dvogureckiy99/stove-master/docs_eng/README.md

 # stove
 
[По-русски](../README.md) | **In english** 
 
## DEVELOPMENT OF THE LAYOUT OF THE SOFTWARE AND HARDWARE COMPLEX FOR TEMPERATURE CONTROL IN FURNACES FOR GLASS MASKS BASED ON THE ATMEGA2560 MICROCONTROLLER
 
 Code use for control temp write in Arduino IDE for board Arduino MEGA.
