dvogureckiy99/stove-master/examples/README.md

# Примеры, которые использовались во время выполнения проекта.
[назад](../README.md)

В [данной папке]() находится проект.

1. Расчёт времени регулирования и запись в файл в [calculating_sattling_time.ino](calculating_sattling_time.ino)

2. Код, который используется для быстрого  написания функций на дисплее [code_for_display.txt](code_for_display.txt)

3. Испытательный код для отработки парсинга строки со значениями точек нагрева с Nextion [Nextion_parsing.cpp](Nextion_parsing.cpp)

4. Проверка на равенство двух массивов [equal_array.cpp](equal_array.cpp)

5. переводит целое число number в строку char* и дополняет слева незначащими нулями
	до длины size. Если количество цифр в числе больше желаемого размера массива, то
	возвращается указатель на нуль символ.
	При успешном выполнении возвращается указатель на требуемую строку. [fix_size.cpp](fix_size.cpp)
