dvogureckiy99/stove-master/docs/images/README.md

# Картинки к проекту 

1. Блок-схема алгоритма Основной алогритм.
