dvogureckiy99/stove-master/docs/stove_bookmarks.md

[назад](../README.md)

<!DOCTYPE NETSCAPE-Bookmark-file-1>
<!-- This is an automatically generated file.
     It will be read and overwritten.
     DO NOT EDIT! -->
<META HTTP-EQUIV="Content-Type" CONTENT="text/html; charset=UTF-8">
<H1>Bookmarks Menu</H1>

<DL><p>
            <DT><H3 ADD_DATE="1589473120" LAST_MODIFIED="1589473121">Stove</H3>
            <DL><p>
                <DT><H3 ADD_DATE="1589473120" LAST_MODIFIED="1589473121">комплектующие</H3>
                <DL><p>
                    <DT><H3 ADD_DATE="1589473120" LAST_MODIFIED="1589473120">PIC18</H3>
                    <DL><p>
                        <DT><A HREF="https://chipmk.ru/2014-08-10-05-51-44/41-samouchitel-pic18-asm-2-chast/190-porty-vvoda-vyvoda-mk-pic18xxxx" ADD_DATE="1551014720" LAST_MODIFIED="1551014720" ICON_URI="fake-favicon-uri:https://chipmk.ru/2014-08-10-05-51-44/41-samouchitel-pic18-asm-2-chast/190-porty-vvoda-vyvoda-mk-pic18xxxx" ICON="">Порты ввода/вывода МК PIC18XXXX.</A>
                        <DT><A HREF="http://picguides.com/beginner/config.php" ADD_DATE="1551014927" LAST_MODIFIED="1551014927">pic guides</A>
                        <DT><A HREF="https://www.youtube.com/watch?v=rUYyZlbiKuc&list=PLIMnyb3KvN1hQQfVPeeVTynqG2ni-zoCh&index=3" ADD_DATE="1558464573" LAST_MODIFIED="1558464573" ICON_URI="fake-favicon-uri:https://www.youtube.com/watch?v=rUYyZlbiKuc&list=PLIMnyb3KvN1hQQfVPeeVTynqG2ni-zoCh&index=3" ICON="">3. Знакомство с программой MPLAB X. (Урок 3. Теория) - YouTube</A>
                    </DL><p>
                    <DT><H3 ADD_DATE="1589473120" LAST_MODIFIED="1589473120">arduino mini</H3>
                    <DL><p>
                        <DT><A HREF="http://doc.arduino.ua/ru/hardware/ProMini" ADD_DATE="1531340918" LAST_MODIFIED="1531340918" ICON_URI="fake-favicon-uri:http://doc.arduino.ua/ru/hardware/ProMini" ICON="">ProMini Платы Ардуино</A>
                        <DT><A HREF="https://all-arduino.ru/arduino-pro-mini/" ADD_DATE="1531249484" LAST_MODIFIED="1531249484" ICON_URI="fake-favicon-uri:https://all-arduino.ru/arduino-pro-mini/" ICON="">Arduino Pro Mini Описание, распиновка, ШИМ, КУПИТЬ.</A>
                        <DT><A HREF="http://arduino.ru/Guide/ArduinoMini" ADD_DATE="1531248896" LAST_MODIFIED="1531248896" ICON_URI="fake-favicon-uri:http://arduino.ru/Guide/ArduinoMini" ICON="">Подключение Arduino Mini | Аппаратная платформа Arduino</A>
                        <DT><A HREF="http://mkprog.ru/avr/avr-dlya-nachinayushhih-urok-3-porty-vvoda-vyvoda.html" ADD_DATE="1532029238" LAST_MODIFIED="1532029238" ICON_URI="fake-favicon-uri:http://mkprog.ru/avr/avr-dlya-nachinayushhih-urok-3-porty-vvoda-vyvoda.html" ICON="">регистры pinx,</A>
                        <DT><A HREF="http://atmega8.ru/wiki/view/doc.24.html" ADD_DATE="1532430288" LAST_MODIFIED="1532430288" ICON_URI="fake-favicon-uri:http://atmega8.ru/wiki/view/doc.24.html" ICON="">ATMega8 / Широтно-импульсная модуляция (ШИМ)</A>
                        <DT><A HREF="https://micro-pi.ru/arduino-pro-mini-%D0%BE%D0%B1%D0%B7%D0%BE%D1%80-%D0%BF%D0%BE%D0%B4%D0%BA%D0%BB%D1%8E%D1%87%D0%B5%D0%BD%D0%B8%D0%B5/" ADD_DATE="1544714093" LAST_MODIFIED="1544714093" ICON_URI="fake-favicon-uri:https://micro-pi.ru/arduino-pro-mini-%D0%BE%D0%B1%D0%B7%D0%BE%D1%80-%D0%BF%D0%BE%D0%B4%D0%BA%D0%BB%D1%8E%D1%87%D0%B5%D0%BD%D0%B8%D0%B5/" ICON="">Arduino Pro Mini - Описание, распиновка платы - MicroPi</A>
                    </DL><p>
                    <DT><H3 ADD_DATE="1589473120" LAST_MODIFIED="1589473120">arduino nano</H3>
                    <DL><p>
                        <DT><A HREF="http://arduino.ru/Hardware/ArduinoBoardnano" ADD_DATE="1534321525" LAST_MODIFIED="1534321525" ICON_URI="fake-favicon-uri:http://arduino.ru/Hardware/ArduinoBoardnano" ICON="">Arduino Nano | Аппаратная платформа Arduino</A>
                        <DT><A HREF="http://arduino.proger.site/faq/icsp" ADD_DATE="1534322704" LAST_MODIFIED="1534322704" ICON_URI="fake-favicon-uri:http://arduino.proger.site/faq/icsp" ICON="">Для чего нужен разъем ISCP на плате ардуино UNO? - FAQ - ARDUINO РОБОТ</A>
                    </DL><p>
                    <DT><H3 ADD_DATE="1589473120" LAST_MODIFIED="1589473120">aduino mega</H3>
                    <DL><p>
                        <DT><A HREF="https://store.arduino.cc/arduino-mega-2560-rev3" ADD_DATE="1535822159" LAST_MODIFIED="1535822159" ICON_URI="fake-favicon-uri:https://store.arduino.cc/arduino-mega-2560-rev3" ICON="">Arduino Mega 2560 Rev3</A>
                        <DT><A HREF="http://wiki.amperka.ru/%D0%BF%D1%80%D0%BE%D0%B4%D1%83%D0%BA%D1%82%D1%8B:arduino-mega-2560" ADD_DATE="1543830371" LAST_MODIFIED="1543830371" ICON_URI="fake-favicon-uri:http://wiki.amperka.ru/%D0%BF%D1%80%D0%BE%D0%B4%D1%83%D0%BA%D1%82%D1%8B:arduino-mega-2560" ICON="">Arduino Mega 2560 [Амперка / Вики]</A>
                        <DT><A HREF="https://voltiq.ru/wp-content/uploads/arduino-mega-2560-pinouts-1019x720.jpg" ADD_DATE="1548351164" LAST_MODIFIED="1548351164" ICON_URI="fake-favicon-uri:https://voltiq.ru/wp-content/uploads/arduino-mega-2560-pinouts-1019x720.jpg" ICON="">arduino-mega-распиновка (1019×720)</A>
                    </DL><p>
                    <DT><A HREF="https://arduinomaster.ru/platy-arduino/maketnaya-plata-arduino/" ADD_DATE="1531589305" LAST_MODIFIED="1531589305" ICON_URI="fake-favicon-uri:https://arduinomaster.ru/platy-arduino/maketnaya-plata-arduino/" ICON="">Беспаечная макетная плата breadboard в проектах Ардуино</A>
                    <DT><A HREF="http://wiki.amperka.ru/%D1%81%D1%85%D0%B5%D0%BC%D0%BE%D1%82%D0%B5%D1%85%D0%BD%D0%B8%D0%BA%D0%B0:%D1%80%D0%B5%D0%B7%D0%B8%D1%81%D1%82%D0%BE%D1%80%D1%8B" ADD_DATE="1531739923" LAST_MODIFIED="1531739923" ICON_URI="fake-favicon-uri:http://wiki.amperka.ru/%D1%81%D1%85%D0%B5%D0%BC%D0%BE%D1%82%D0%B5%D1%85%D0%BD%D0%B8%D0%BA%D0%B0:%D1%80%D0%B5%D0%B7%D0%B8%D1%81%D1%82%D0%BE%D1%80%D1%8B" ICON="">Резисторы [Амперка / Вики]</A>
                    <DT><H3 ADD_DATE="1589473120" LAST_MODIFIED="1589473120">термопары</H3>
                    <DL><p>
                        <DT><H3 ADD_DATE="1589473120" LAST_MODIFIED="1589473120">термоконтроллео через spi</H3>
                        <DL><p>
                            <DT><A HREF="http://www.count-zero.ru/2015/max6675/" ADD_DATE="1532019486" LAST_MODIFIED="1532019486" ICON_URI="fake-favicon-uri:http://www.count-zero.ru/2015/max6675/" ICON="">Подключение термопары К-типа к Arduino используя модуль на MAX6675</A>
                            <DT><A HREF="http://www.count-zero.ru/2015/spi/" ADD_DATE="1532019520" LAST_MODIFIED="1532019520" ICON_URI="fake-favicon-uri:http://www.count-zero.ru/2015/spi/" ICON="">Программная реализация SPI интерфейса, на примере подключения термопары K-типа, через адаптер MAX6675 к микроконтроллеру ATmega8</A>
                        </DL><p>
                        <DT><A HREF="https://www.maximintegrated.com/en/products/sensors/MAX31856.html" ADD_DATE="1531761697" LAST_MODIFIED="1531761697" ICON_URI="fake-favicon-uri:https://www.maximintegrated.com/en/products/sensors/MAX31856.html" ICON="">Термопара точности MAX31856 к цифровому Преобразователю с Выпрямлением-Максим</A>
                        <DT><A HREF="http://www.goodluckbuy.com/cjmcu-max31856-thermocouple-module-high-precision-development-board.html" ADD_DATE="1531761273" LAST_MODIFIED="1531761273" ICON_URI="fake-favicon-uri:http://www.goodluckbuy.com/cjmcu-max31856-thermocouple-module-high-precision-development-board.html" ICON="">CJMCU-MAX31856 Thermocouple Module High Precision Development Board $18.97 Free Shipping @GoodLuckBuy.com</A>
                        <DT><A HREF="https://www.compel.ru/2015/12/22/max31856-atsp-dlya-termopar-s-zashhitoy-i-linearizatsiey" ADD_DATE="1531761363" LAST_MODIFIED="1531761363" ICON_URI="fake-favicon-uri:https://www.compel.ru/2015/12/22/max31856-atsp-dlya-termopar-s-zashhitoy-i-linearizatsiey" ICON="">MAX31856 – АЦП для термопар с защитой и линеаризацией</A>
                        <DT><A HREF="https://learn.adafruit.com/adafruit-max31856-thermocouple-amplifier/wiring-and-test" ADD_DATE="1532110282" LAST_MODIFIED="1532110282" ICON_URI="fake-favicon-uri:https://learn.adafruit.com/adafruit-max31856-thermocouple-amplifier/wiring-and-test" ICON="">Wiring &amp; Test | Adafruit MAX31856 Universal Thermocouple Amplifier | Adafruit Learning System</A>
                        <DT><A HREF="http://docs.cntd.ru/document/1200028583" ADD_DATE="1532168873" LAST_MODIFIED="1532168873" ICON_URI="fake-favicon-uri:http://docs.cntd.ru/document/1200028583" ICON="">ГОСТ Р 8.585-2001 Государственная система обеспечения единства измерений (ГСИ). Термопары. Номинальные статические характеристики преобразова</A>
                        <DT><A HREF="https://github.com/engineertype/MAX31856" ADD_DATE="1536413307" LAST_MODIFIED="1536413307" ICON_URI="fake-favicon-uri:https://github.com/engineertype/MAX31856" ICON="">MAX31856</A>
                        <DT><A HREF="http://arduino.ru/forum/programmirovanie/otkuda-arduino-ide-beret-inkludy" ADD_DATE="1536418636" LAST_MODIFIED="1536418636" ICON_URI="fake-favicon-uri:http://arduino.ru/forum/programmirovanie/otkuda-arduino-ide-beret-inkludy" ICON="">Откуда Arduino IDE берет инклуды? | Аппаратная платформа Arduino</A>
                    </DL><p>
                    <DT><H3 ADD_DATE="1589473121" LAST_MODIFIED="1589473121">тестеры</H3>
                    <DL><p>
                        <DT><A HREF="http://www.radiomexanik.spb.ru/7.-izmeritelnyie-priboryi/3.-vozdeystvie-voltmetra-na-izmeryaemuyu-tsep.html" ADD_DATE="1532171627" LAST_MODIFIED="1532171627" ICON_URI="fake-favicon-uri:http://www.radiomexanik.spb.ru/7.-izmeritelnyie-priboryi/3.-vozdeystvie-voltmetra-na-izmeryaemuyu-tsep.html" ICON="">3. Воздействие вольтметра на измеряемую цепь | 7. Измерительные приборы | Часть1 - DС</A>
                    </DL><p>
                    <DT><H3 ADD_DATE="1589473121" LAST_MODIFIED="1589473121">пид-регулятор</H3>
                    <DL><p>
                        <DT><A HREF="http://brettbeauregard.com/blog/2011/04/improving-the-beginners-pid-introduction/" ADD_DATE="1532173038" LAST_MODIFIED="1532173038">Improving the Beginner’s PID – Introduction « Project Blog</A>
                        <DT><A HREF="http://playground.arduino.cc/Code/PIDLibrary" ADD_DATE="1532177255" LAST_MODIFIED="1532177255" ICON_URI="fake-favicon-uri:http://playground.arduino.cc/Code/PIDLibrary" ICON="">Arduino Playground - PIDLibrary</A>
                        <DT><A HREF="https://github.com/br3ttb/Arduino-PID-Library" ADD_DATE="1532177259" LAST_MODIFIED="1532177259" ICON_URI="fake-favicon-uri:https://github.com/br3ttb/Arduino-PID-Library" ICON="">br3ttb/Arduino-PID-Library</A>
                        <DT><A HREF="http://mypractic.ru/urok-40-pid-regulyator-princip-dejstviya-matematicheskoe-opisanie-nastrojka.html" ADD_DATE="1532177265" LAST_MODIFIED="1532177265" ICON_URI="fake-favicon-uri:http://mypractic.ru/urok-40-pid-regulyator-princip-dejstviya-matematicheskoe-opisanie-nastrojka.html" ICON="">Уроки Ардуино. ПИД регулятор. Принцип действия, математическое описание, настройка. | Оборудование, технологии, разработки</A>
                        <DT><A HREF="http://bigbarrel.ru/arduino_pid/" ADD_DATE="1532177269" LAST_MODIFIED="1532177269" ICON_URI="fake-favicon-uri:http://bigbarrel.ru/arduino_pid/" ICON="">PID регулятор температуры. Климат контроль на Ардуино. Библиотека PID ← BigBarrel.ru</A>
                        <DT><A HREF="https://studopedia.ru/7_161119_nastroyka-parametrov-regulyatora-po-metodu-ziglera-i-nikolsa.html" ADD_DATE="1532370032" LAST_MODIFIED="1532370032" ICON_URI="fake-favicon-uri:https://studopedia.ru/7_161119_nastroyka-parametrov-regulyatora-po-metodu-ziglera-i-nikolsa.html" ICON="">Настройка параметров регулятора по методу Зиглера и Никольса — Студопедия</A>
                        <DT><A HREF="http://lazysmart.ru/osnovy-avtomatiki/nastrojka-pid-regulyatora/" ADD_DATE="1536432524" LAST_MODIFIED="1536432524" ICON_URI="fake-favicon-uri:http://lazysmart.ru/osnovy-avtomatiki/nastrojka-pid-regulyatora/" ICON="">Практические советы по настройке ПИД-регулятора | LAZY SMART</A>
                    </DL><p>
                    <DT><H3 ADD_DATE="1589473121" LAST_MODIFIED="1589473121">аналоговая схемотехника</H3>
                    <DL><p>
                        <DT><H3 ADD_DATE="1589473121" LAST_MODIFIED="1589473121">семистр</H3>
                        <DL><p>
                        </DL><p>
                    </DL><p>
                    <DT><H3 ADD_DATE="1589473121" LAST_MODIFIED="1589473121">дисплей</H3>
                    <DL><p>
                        <DT><A HREF="https://ru.made-in-china.com/co_nextion/product_Nextion-Enhanced-Nx8048k050-Generic-5-0-HMI-Touch-Display_rurhihiyg.html" ADD_DATE="1533236357" LAST_MODIFIED="1533236357" ICON_URI="fake-favicon-uri:https://ru.made-in-china.com/co_nextion/product_Nextion-Enhanced-Nx8048k050-Generic-5-0-HMI-Touch-Display_rurhihiyg.html" ICON="">Усовершенствованная Nextion Nx8048K050 - 5,0&quot; сенсорный экран ИЧМ – Усовершенствованная Nextion Nx8048K050 - 5,0&quot; сенсорный экран ИЧМ предоставлен Itead Intelligent Syst</A>
                        <DT><A HREF="https://ru.aliexpress.com/item/Nextion-5-0-NX8048K050-800x480-UART/32892259749.html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" ADD_DATE="1533236488" LAST_MODIFIED="1533236488" ICON_URI="fake-favicon-uri:https://ru.aliexpress.com/item/Nextion-5-0-NX8048K050-800x480-UART/32892259749.html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" ICON="">Nextion расширение 5,0 &quot;NX8048K050 800x480 резистивный Сенсорный экран ичм UART Smart Дисплей модуль для Arduino Raspberry Pi ESP8266 купить на AliExpress</A>
                        <DT><A HREF="https://www.itead.cc/ru/nextion-nx8048t050.html" ADD_DATE="1533236565" LAST_MODIFIED="1533236565" ICON_URI="fake-favicon-uri:https://www.itead.cc/ru/nextion-nx8048t050.html" ICON="">Nextion NX8048T050 5&quot; HMI TFT LCD Интеллектуальный сенсорный дисплей</A>
                        <DT><A HREF="https://nextion.itead.cc/resources/datasheets/nx8048k050_011/" ADD_DATE="1533236689" LAST_MODIFIED="1533236689" ICON_URI="fake-favicon-uri:https://nextion.itead.cc/resources/datasheets/nx8048k050_011/" ICON="">NX8048K050_011 - Nextion</A>
                        <DT><A HREF="https://www.ti.com/lit/an/slyt209a/slyt209a.pdf" ADD_DATE="1533237334" LAST_MODIFIED="1533237334" ICON_URI="fake-favicon-uri:https://www.ti.com/lit/an/slyt209a/slyt209a.pdf" ICON="">Using resistive touch screens for human/machine interface</A>
                        <DT><A HREF="http://easyelectronics.ru/rabota-s-rezistivnym-sensornym-ekranom.html" ADD_DATE="1533240290" LAST_MODIFIED="1533240290" ICON_URI="fake-favicon-uri:http://easyelectronics.ru/rabota-s-rezistivnym-sensornym-ekranom.html" ICON="">Работа с резистивным сенсорным экраном | Электроника для всех</A>
                        <DT><A HREF="https://wiki.iarduino.ru/page/Nextion/" ADD_DATE="1533242000" LAST_MODIFIED="1533242000" ICON_URI="fake-favicon-uri:https://wiki.iarduino.ru/page/Nextion/" ICON="">Описание работы с TFT Nextion экранами (первый запуск, создание интерфейса, обработчик для arduino) - Описания, примеры, подключение к Arduino</A>
                        <DT><A HREF="https://www.itead.cc/wiki/Nextion_Instruction_Set#Note:" ADD_DATE="1534324047" LAST_MODIFIED="1534324047" ICON_URI="fake-favicon-uri:https://www.itead.cc/wiki/Nextion_Instruction_Set#Note:" ICON="">Nextion Instruction Set — ITEAD Wiki</A>
                        <DT><A HREF="https://nextion.itead.cc/resources/documents/instruction-set/" ADD_DATE="1539700442" LAST_MODIFIED="1539700442" ICON_URI="fake-favicon-uri:https://nextion.itead.cc/resources/documents/instruction-set/" ICON="">Instruction Set - Nextion</A>
                        <DT><A HREF="https://ru.aliexpress.com/popular/display-nextion.html" ADD_DATE="1532429382" LAST_MODIFIED="1532429382" ICON_URI="fake-favicon-uri:https://ru.aliexpress.com/popular/display-nextion.html" ICON="">Display Nextion – Купить Display Nextion недорого из Китая на AliExpress</A>
                        <DT><A HREF="http://forum.amperka.ru/threads/%D0%94%D0%B8%D1%81%D0%BF%D0%BB%D0%B5%D0%B9-nextion-%D0%B0%D0%B7%D1%8B-arduino-esp8266.9204/page-3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" ADD_DATE="1536688549" LAST_MODIFIED="1536688549" ICON_URI="fake-favicon-uri:http://forum.amperka.ru/threads/%D0%94%D0%B8%D1%81%D0%BF%D0%BB%D0%B5%D0%B9-nextion-%D0%B0%D0%B7%D1%8B-arduino-esp8266.9204/page-3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" ICON="">Дисплей Nextion: азы. Arduino, ESP8266. | Страница 3 | Амперка / Форум</A>
                        <DT><A HREF="https://github.com/itead/ITEADLIB_Arduino_Nextion" ADD_DATE="1536688554" LAST_MODIFIED="1536688554" ICON_URI="fake-favicon-uri:https://github.com/itead/ITEADLIB_Arduino_Nextion" ICON="">GitHub - itead/ITEADLIB_Arduino_Nextion</A>
                        <DT><A HREF="http://qsy.by/nextion-editor-znakomstvo-s-interfejsom/" ADD_DATE="1539706322" LAST_MODIFIED="1539706322" ICON_URI="fake-favicon-uri:http://qsy.by/nextion-editor-znakomstvo-s-interfejsom/" ICON="">Nextion Editor. Знакомство с интерфейсом. | QSY.BY</A>
                        <DT><A HREF="https://habr.com/company/flprog/blog/392561/?mobile=yes" ADD_DATE="1540125734" LAST_MODIFIED="1540125734" ICON_URI="fake-favicon-uri:https://habr.com/company/flprog/blog/392561/?mobile=yes" ICON="">FLProg + Nextion HMI. Урок 1 / Блог компании FLProg / Хабр</A>
                    </DL><p>
                    <DT><H3 ADD_DATE="1589473121" LAST_MODIFIED="1589473121">память</H3>
                    <DL><p>
                        <DT><A HREF="https://ru.wikipedia.org/wiki/EEPROM" ADD_DATE="1534413402" LAST_MODIFIED="1534413402" ICON_URI="fake-favicon-uri:https://ru.wikipedia.org/wiki/EEPROM" ICON="">EEPROM — Википедия</A>
                    </DL><p>
                    <DT><H3 ADD_DATE="1589473121" LAST_MODIFIED="1589473121">модуль SD-card</H3>
                    <DL><p>
                        <DT><A HREF="http://roboparts.ru/products/4158987" ADD_DATE="1544461999" LAST_MODIFIED="1544461999" ICON_URI="fake-favicon-uri:http://roboparts.ru/products/4158987" ICON="">Модуль SD карты</A>
                        <DT><A HREF="https://arduinomaster.ru/datchiki-arduino/podklyuchenie-sd-karty-k-arduino/" ADD_DATE="1544462286" LAST_MODIFIED="1544462286" ICON_URI="fake-favicon-uri:https://arduinomaster.ru/datchiki-arduino/podklyuchenie-sd-karty-k-arduino/" ICON="">Подключение sd карты к ардуино - ArduinoMaster все об Ардуино</A>
                        <DT><A HREF="http://arduino-diy.com/arduino-SD-karta" ADD_DATE="1544462871" LAST_MODIFIED="1544462871" ICON_URI="fake-favicon-uri:http://arduino-diy.com/arduino-SD-karta" ICON="">Модуль SD карты и Arduino||Arduino-diy.com</A>
                    </DL><p>
                    <DT><A HREF="http://yandex.ru/clck/jsredir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,&sign=994612c81cbfacbee48a6ecb0426110a&keyno=0&b64e=2&ref=orjY4mGPRjk5boDnW0uvlrrd71vZw9kpuILuEi-MOSLEs7JgxA_g8_pr9lTk5pMgPCTZ9ZaqkM3NpyzaNnAtWFEq4UieeBCG&l10n=ru&rp=1&cts=1544619172708&mc=2.2516291673878226&hdtime=4400.5" ADD_DATE="1544619174" LAST_MODIFIED="1544619174" ICON_URI="fake-favicon-uri:http://yandex.ru/clck/jsredir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,&sign=994612c81cbfacbee48a6ecb0426110a&keyno=0&b64e=2&ref=orjY4mGPRjk5boDnW0uvlrrd71vZw9kpuILuEi-MOSLEs7JgxA_g8_pr9lTk5pMgPCTZ9ZaqkM3NpyzaNnAtWFEq4UieeBCG&l10n=ru&rp=1&cts=1544619172708&mc=2.2516291673878226&hdtime=4400.5" ICON=""></A>
                    <DT><H3 ADD_DATE="1589473121" LAST_MODIFIED="1589473121">arduino uno</H3>
                    <DL><p>
                        <DT><A HREF="http://arduino.ru/Hardware/ArduinoBoardUno" ADD_DATE="1544720296" LAST_MODIFIED="1544720296" ICON_URI="fake-favicon-uri:http://arduino.ru/Hardware/ArduinoBoardUno" ICON="">Arduino Uno | Аппаратная платформа Arduino</A>
                    </DL><p>
                </DL><p>
            </DL><p>
</DL>
