dvogureckiy99/stove-master/examples/matlab_stepinfo/Stepinfo Documentation.odt

function stepinfo(sys)

This function computes sytem characteristics when step input is given to the system.

stepinfo(Y,T,YFINAL) computes the following parameters assuming zero initial conditions and no input offset.

- RiseTime: rise time of the system
- SettlingTime: settling time
- SettlingMin: min value of Y once the response has risen
- SettlingMax: max value of Y once the response has risen
- Overshoot: percentage overshoot (relative to YFINAL)
- Undershoot: percentage undershoot
- Peak: peak absolute value of Y
- PeakTime: time at which peak absolute value is reached.

stepinfo(Y,T,YFINAL)

For SISO systems Y and T are vectors of same length NS.

For MIMO systems with NU inputs, NY outputs, Y should be

specified as an array of size NS-by-NY-by-NU.

Similarly, YFINAL should be specified as a NY-by-NU array.

Then the function returns an output array of each quantity

of size NY-by-NU.

stepinfo(Y,T) uses the last sampled value of Y as the YFINAL

stepinfo(Y) assumes T = 1:NS.

stepinfo(sys) calculates the time response characteristics of

dynamic system sys. The Rise Time, Settling Time etc. are all

calculated in Time Units of the system.

The default value of RiseTimeLims = [0.1 0.9] ie. from 10% to 90% of the final value.

The user may change the limits by setting RiseTimeLims to the desired values.

Example 1 :

If the desired value of rise time is from 5% to 95% of the final value, then the command looks like

stepinfo(y,t,yfinal,'RiseTimeLims'[0.05 0.95])

Settling time with default 2% limits

The user may change this by setting SettlingTimeThreshold to the desired value.

Example 2:

If the desired value of settling time threshold is 5% of the final value, then the command looks like

stepinfo(sys,'SettlingTimeThreshold',0.05)

The function is also capable of giving Rise time high and rise time low. These values are not printed by default but they can be assigned to a variable.

RiseTimeHigh, RiseTimeLow can be extracted using the function in the following way

Example 3:

[x1 x2 x3 x4 x5 x6 x7 x8 x9 x10] = stepinfo(Y,T,YFINAL)

Then the variables x9 and x10 will give the values of RiseTimeHigh and RiseTimeLow respectively.

Example 4 :

s = %s ;

sys = syslin('c',(s+6)/(s^2+6*s+4)) ;

stepinfo(sys) ;

Some comments about the function

I have tried to make the program modular and easy to understand. There is a different function for each parameter such as overshoot, peak, rise_time are all being calculated from different functions. Each minor function in itself works for SISO input. Now I have called all these functions from my main function “stepinfo”. If the input is a MIMO system, then the loop inside the main functions runs ‘for’ loop the appropriate number of times such that it works absolutely fine for MIMO system also.

For any type of system the main function (stepinfo) calls the other functions giving all the values of y, t and yfinal. For every system a ‘y’ matrix (containing the corresponding time response values) is generated using “csim” for continuous systems and “flts” for discrete system. And then this ‘y’ matrix (with ‘t’ and ‘yfinal’) is passed to the corresponding functions for calculation of the system’s performance parameters. Then these performance parameters are constantly stored in the form of the matrix, where the size of matrix depends on the size of input. Then I have printed all the corresponding matrices using the ‘disp’ command.

Problems Faced

- What should be the time range and sampling time for the calculation of ‘y’ matrix. ? This problem was solved by checking the stability of the system and running a stable system from t=0 to t = 1000 seconds. Then seeing the time at which the system settles. When the ‘y’ equals ‘yfinal’ for consecutive (9-10) points, then this indicates that the system has settled. Then the y matrix was computed from t=0 to the time where system is settling . The code is as follows :
  y_temp = csim('step',0:1:1010,sys) ;

yfinal = horner(sys,0.00001)

//Final Value theorem for calculation of yfinal

//In case of step input final value = limit s -> 0, C(s)

for i = [1:1:1000]

temp = y_temp(i:i+9) ;

if (abs(temp- yfinal) < = 0.0001)

break

end

end

t = 0:(i+9)/10000:i+9 ;

y = csim('step',t,sys) ;

References :

- http://www.scilab.org/resources/documentation ;
- http://spoken-tutorial.org/
- http://in.mathworks.com/help/control/ ;
- http://in.mathworks.com/help/control/ref/stepinfo.html ;
- https://en.wikipedia.org/wiki/Control_systems;

Author(s):

Sanchit Gupta
