dvogureckiy99/stove-master/HMI_Nextion/TT_interface.pdf

12 | : | 12 | : | 24

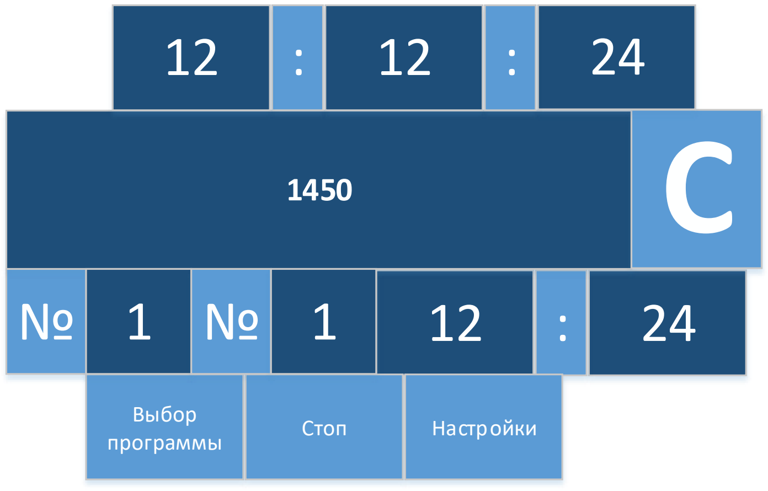
[picture p34: page 1]

1450 C

| 1 | | 1 | 12 | : | 24
Выбор программы | Стоп | Настройки

На главную

1 | 12 | : | 24

С

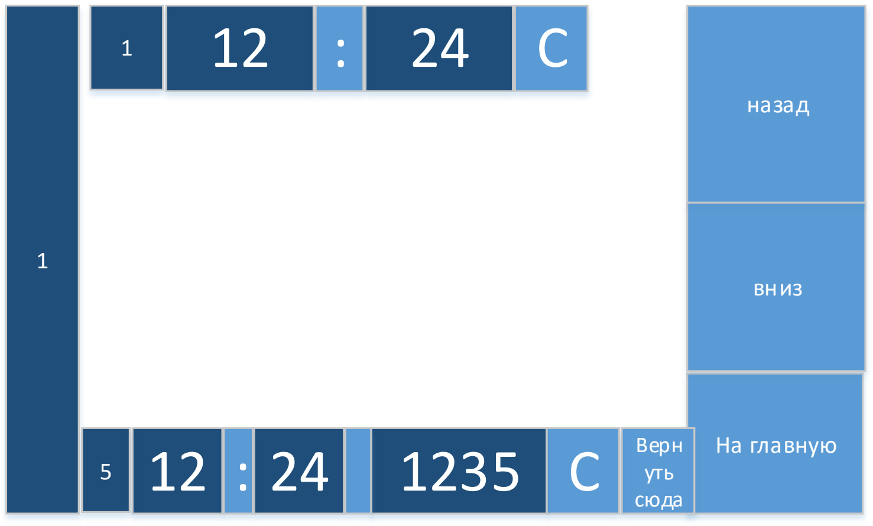
[picture p35: page 3]

На главную

1
вниз

Верн
уть
сюда
5 | 12 | : | 24 | 1235 | С

назад

5 | 12 | : | 24

С

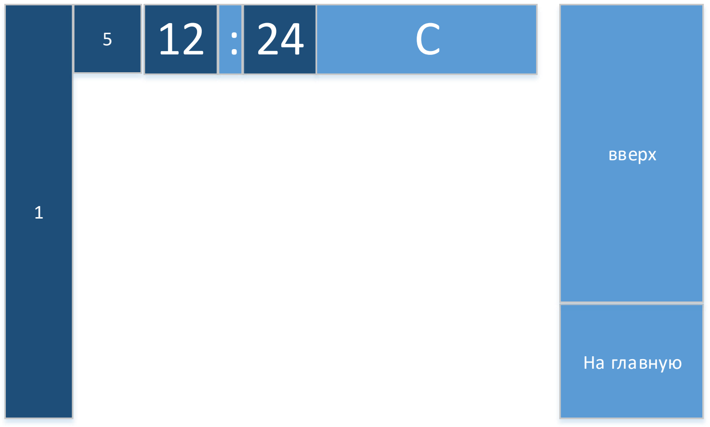
[picture p36: page 4]

На главную

1

вверх

5 | 12 | : | 24 | С

1235

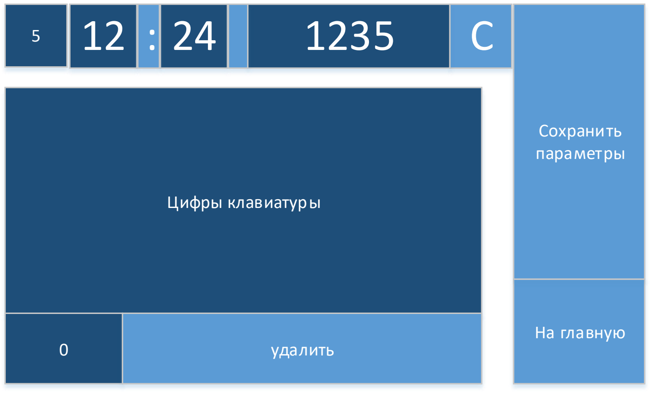
[picture p37: page 5]

На главную

Сохранить
параметры

Цифры клавиатуры

0 | удалить

Темно голубые блоки — числа, каким-то шрифтом, нужно только сделать картинку для заднего фона чисел
Синие блоки – блоки, кнопки, текст и т.д., на которые будет наложена картинка.
