dvogureckiy99/stove-master/docs/pseudo-code_handwritten_outline/ACS_model.pdf

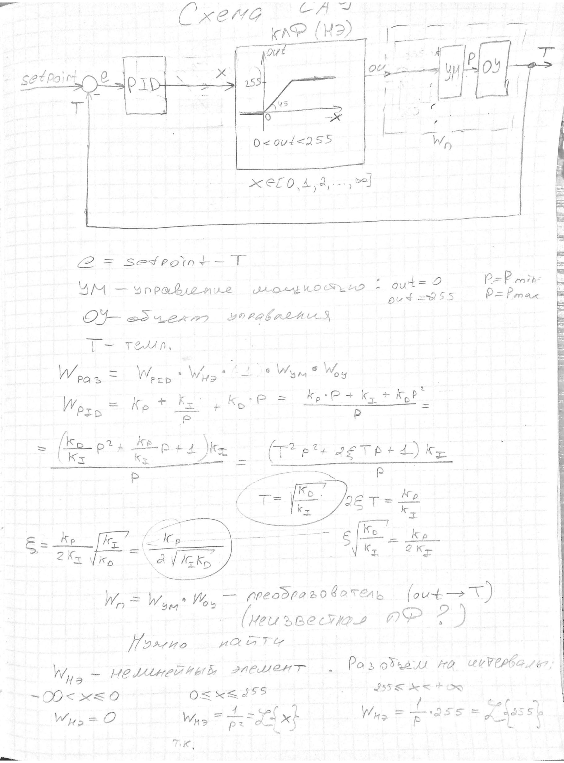
[picture p46: page 1]
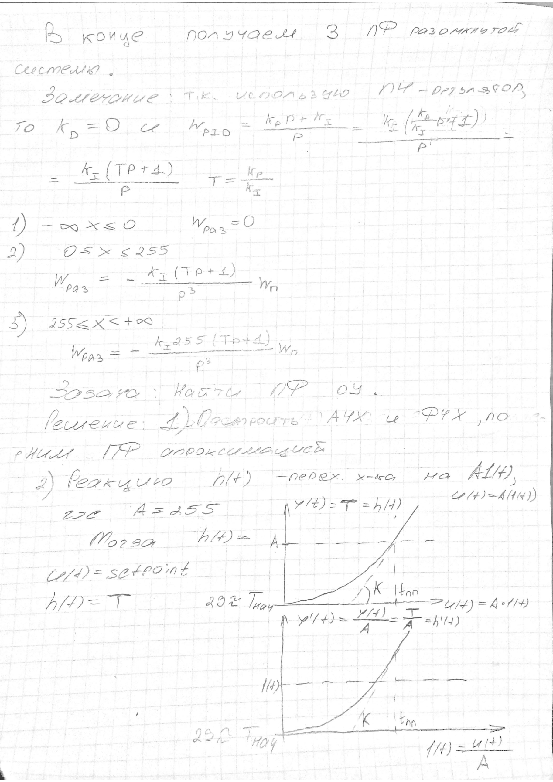
[picture p47: page 2]
