dvogureckiy99/stove-master/docs/pseudo-code_handwritten_outline/PIR_setting1.pdf

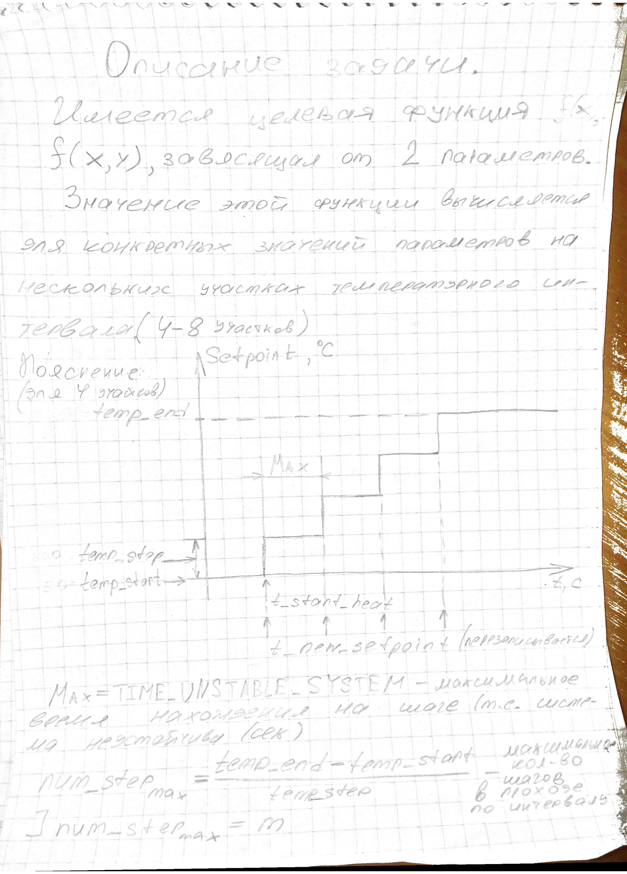
[picture p48: page 1]
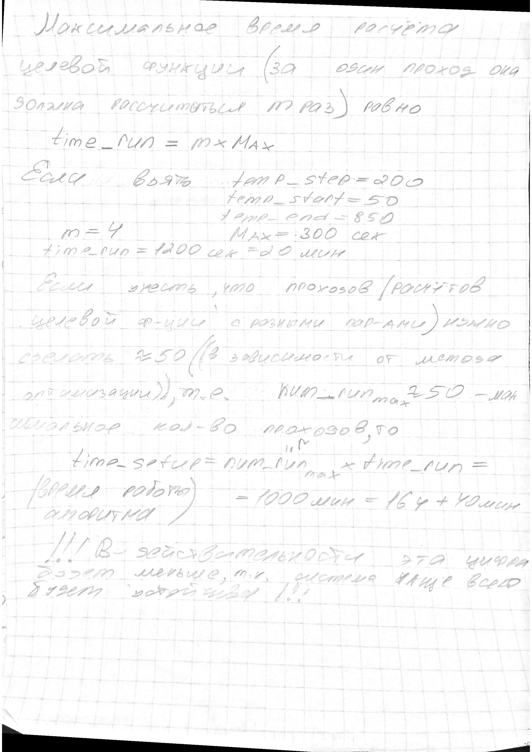
[picture p49: page 2]
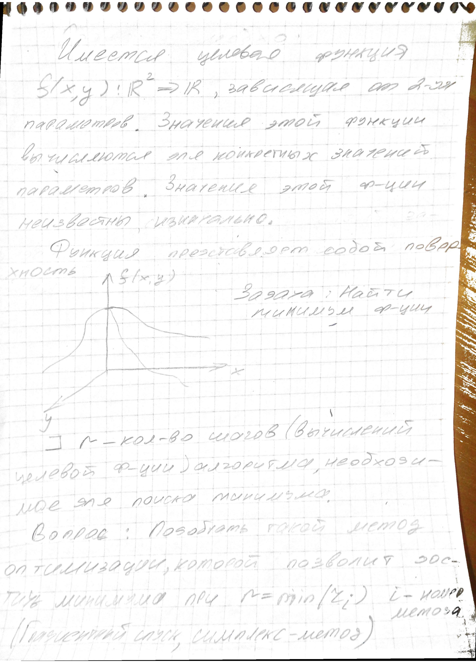
[picture p50: page 3]
