dvogureckiy99/stove-master/docs/pseudo-code_handwritten_outline/PIR_setting2.pdf

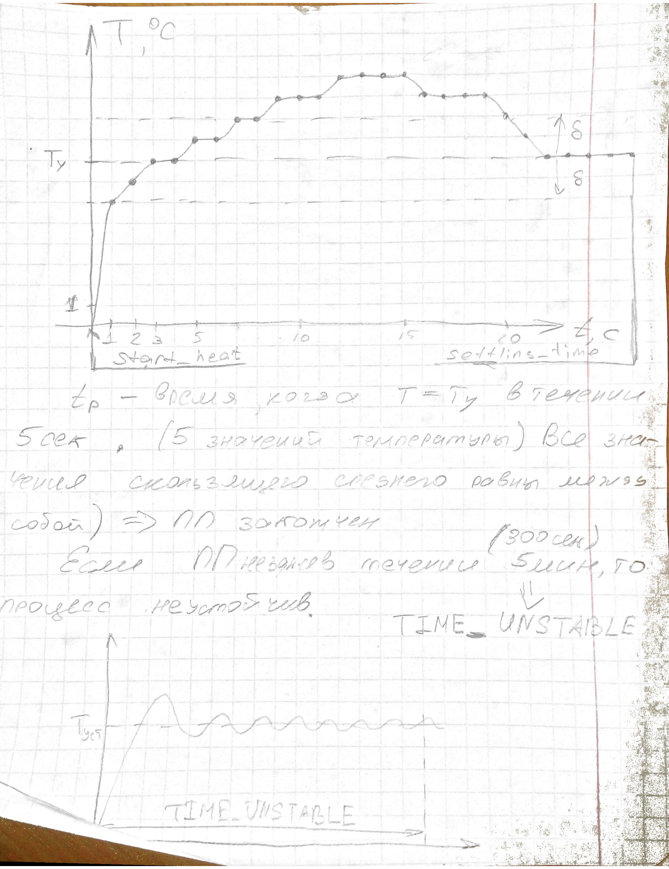
[picture p51: page 1]
