dvogureckiy99/stove-master/docs/pseudo-code_handwritten_outline/var_length_in_memory.pdf

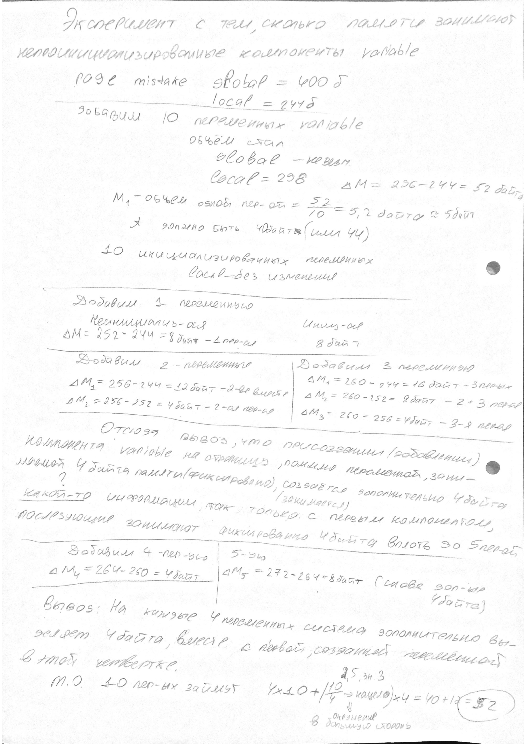
[picture p52: page 1]
