dvogureckiy99/stove-master/docs/images/20181205_164535.jpg

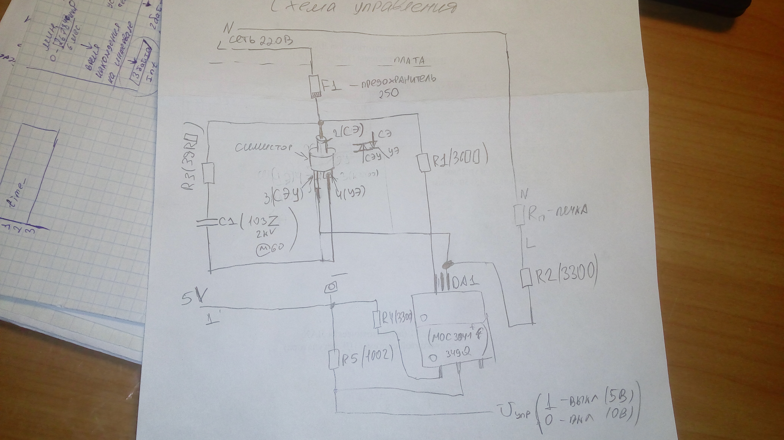
docs/images/20181205_164535.jpg
