dvogureckiy99/stove-master/docs/images/20190215_214910.jpg

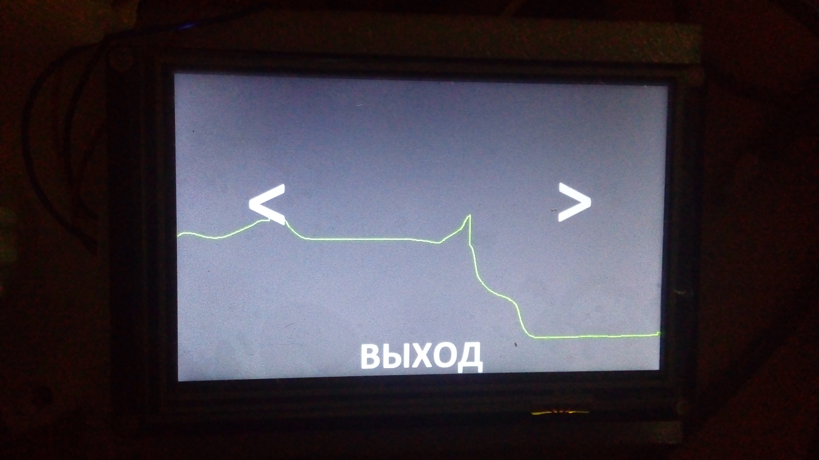
docs/images/20190215_214910.jpg
