dvogureckiy99/stove-master/docs/images/linear.png

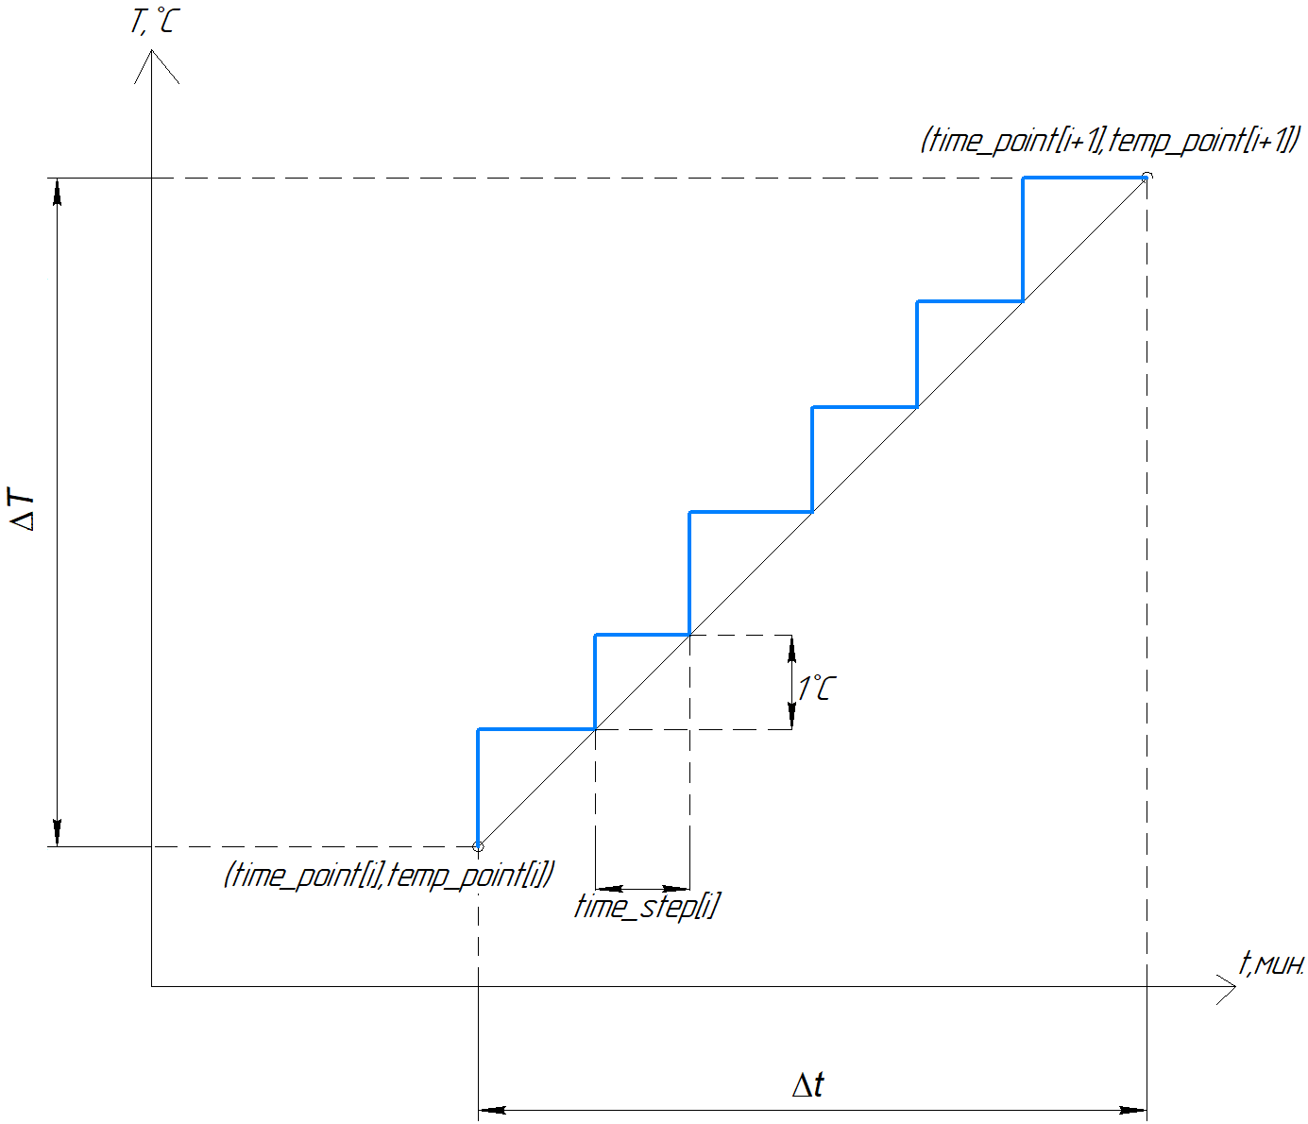
docs/images/linear.png
