dvogureckiy99/stove-master/docs/images/photos/8PRMh0adSmc.jpg

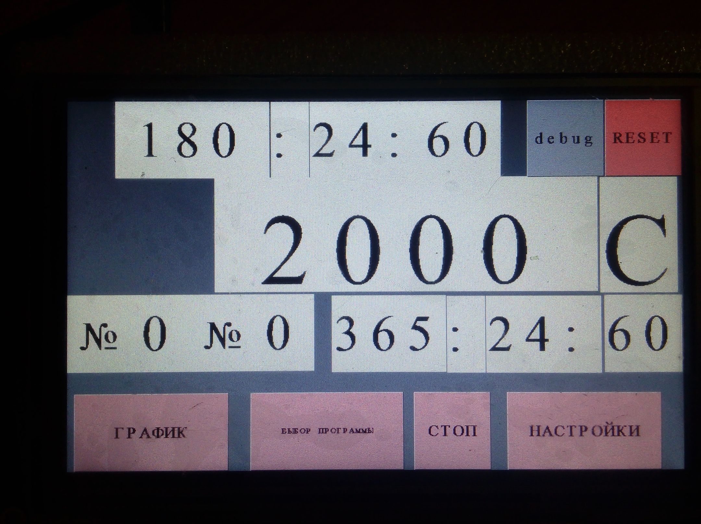
docs/images/photos/8PRMh0adSmc.jpg
