dvogureckiy99/stove-master/docs/images/photos/20181204_172831.jpg

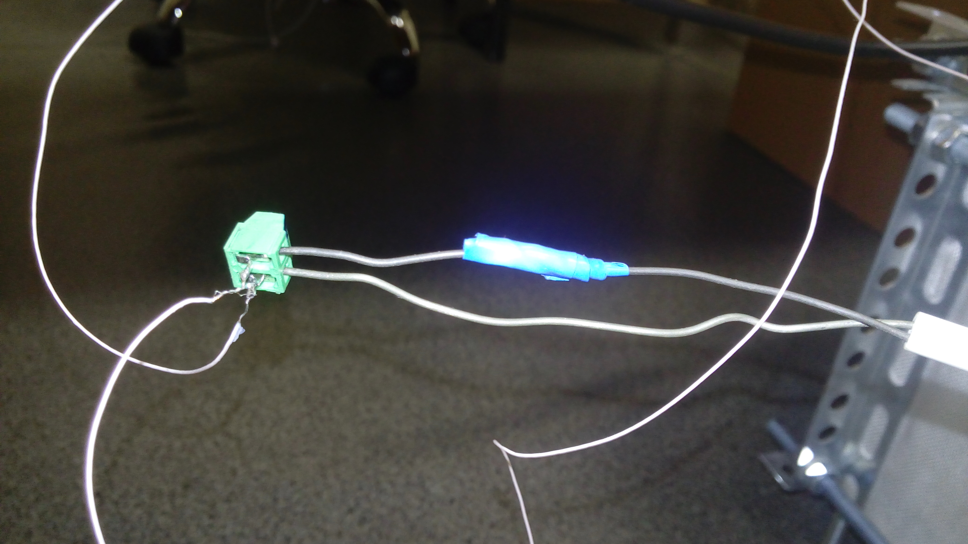
docs/images/photos/20181204_172831.jpg
