dvogureckiy99/stove-master/docs/images/photos/20181204_173148.jpg

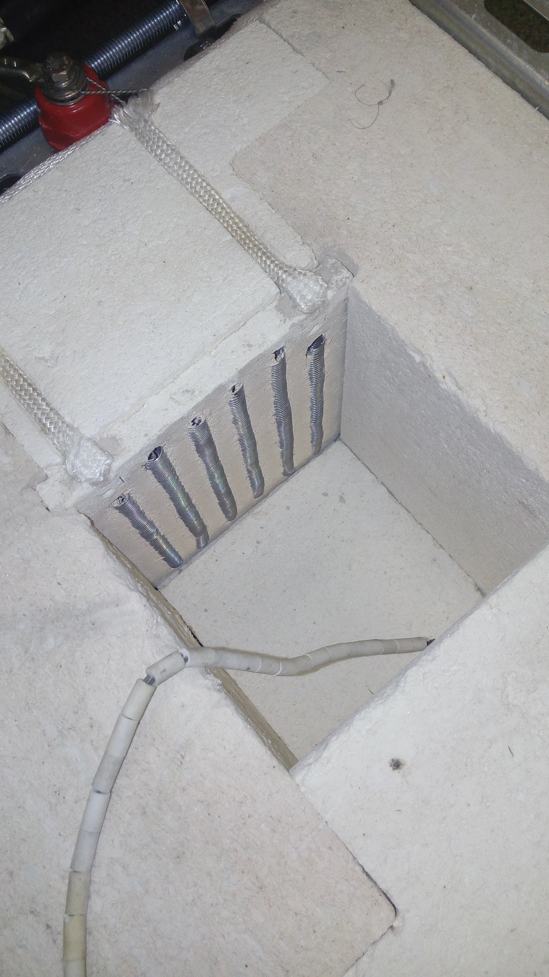
docs/images/photos/20181204_173148.jpg
