dvogureckiy99/stove-master/docs/images/график_управление семистором с основными константами.jpg

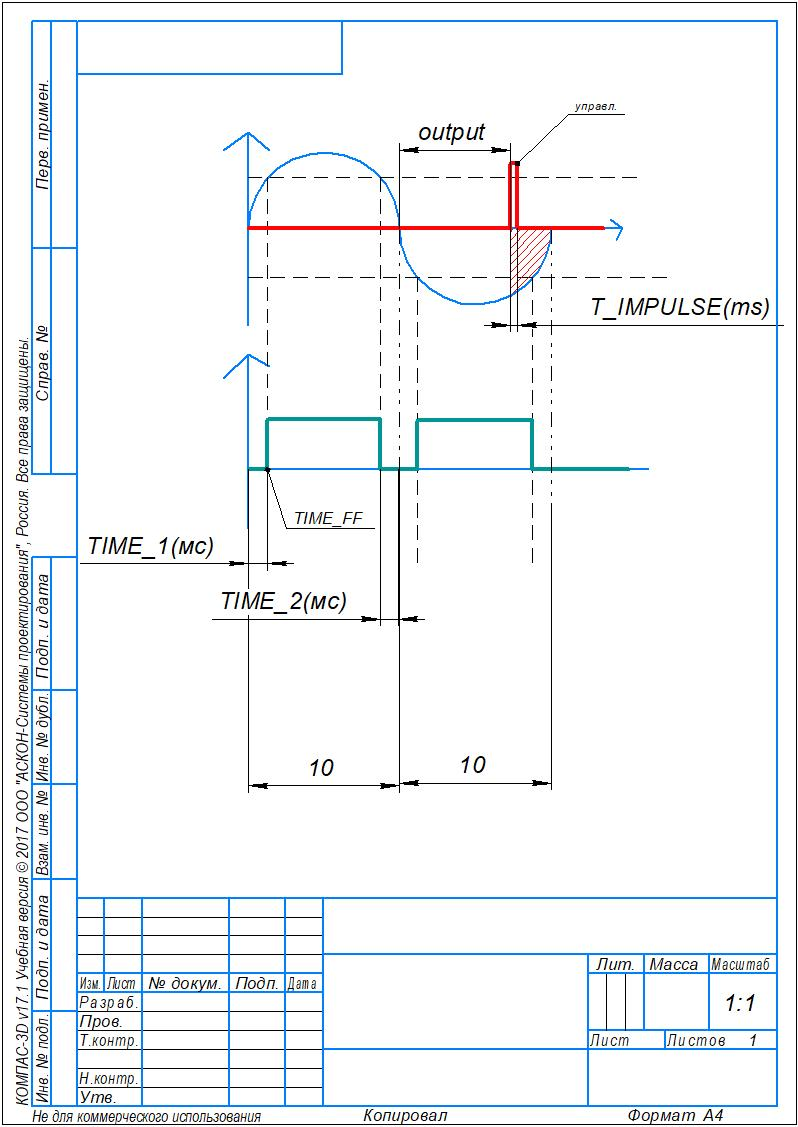
docs/images/график_управление семистором с основными константами.jpg
