dvogureckiy99/stove-master/HMI_Nextion/images_for_HMI/first_interface.jpg

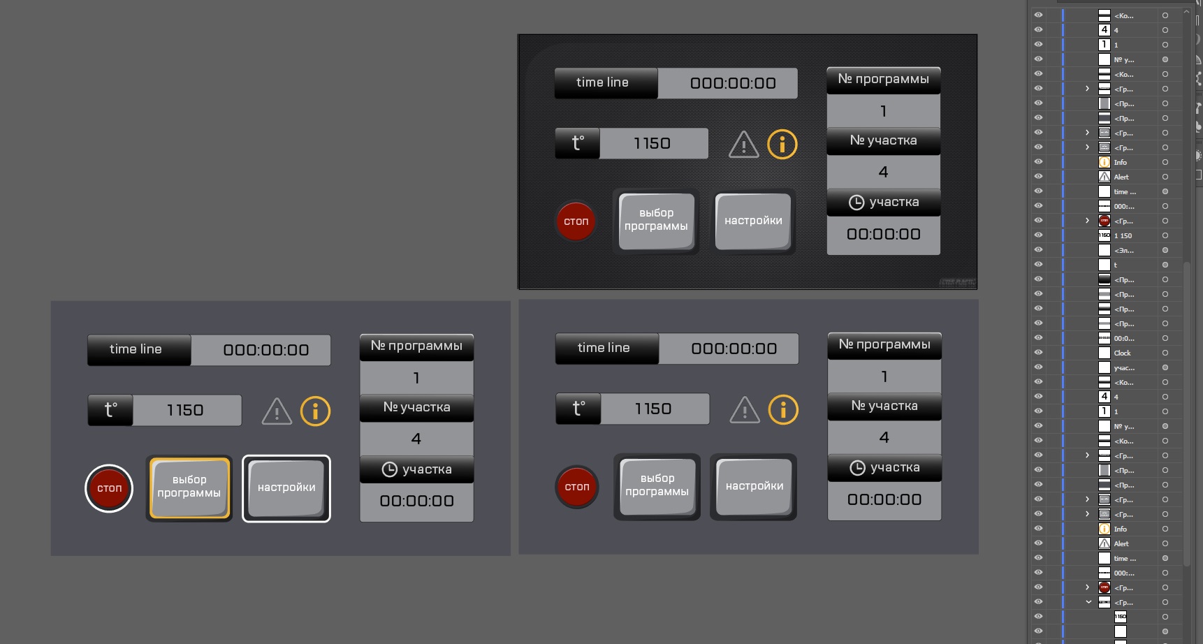
HMI_Nextion/images_for_HMI/first_interface.jpg
