dvogureckiy99/stove-master/HMI_Nextion/images_for_HMI/graph/background.bmp

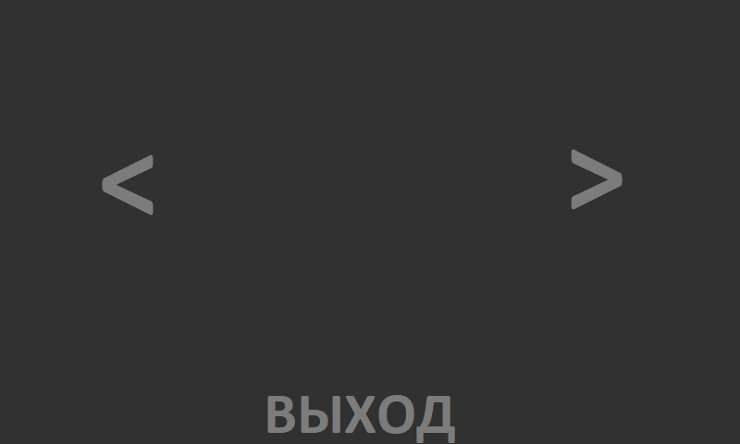
HMI_Nextion/images_for_HMI/graph/background.bmp
