dvogureckiy99/stove-master/components/README.md

# Документация на компоненты

[назад](../README.md)
