dvogureckiy99/stove-master/components/arduino mini/curcuit/ArduinoMini.png

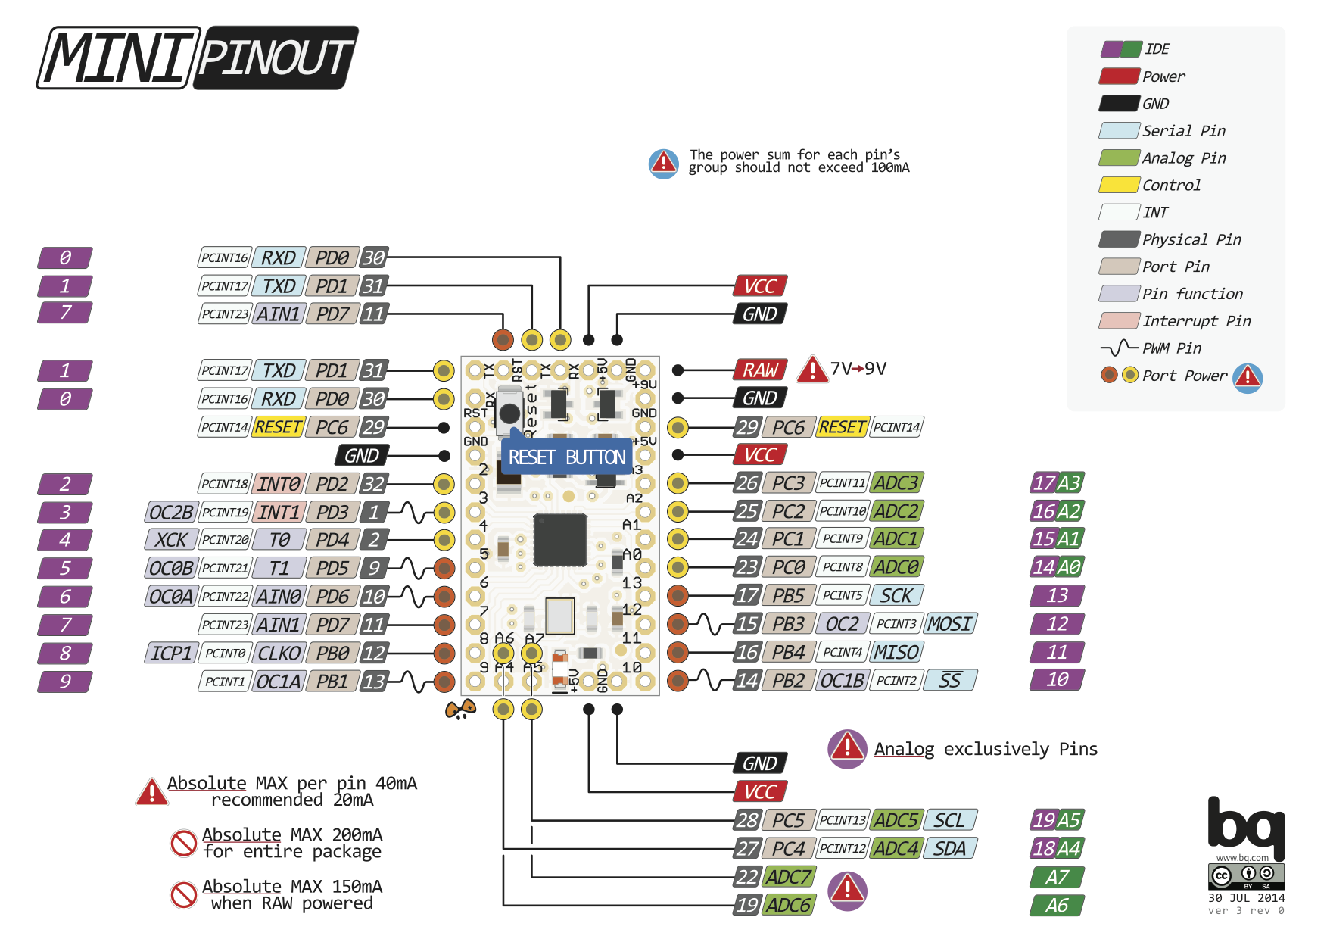
components/arduino mini/curcuit/ArduinoMini.png
