dvogureckiy99/stove-master/components/MEGA/-Arduino-Mega-2560-R3.jpg

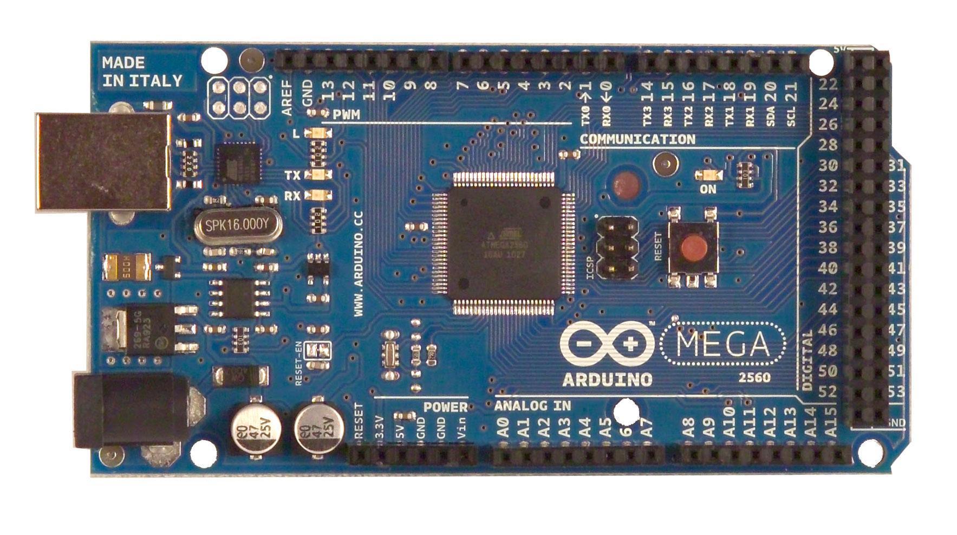
components/MEGA/-Arduino-Mega-2560-R3.jpg
