dvogureckiy99/stove-master/docs/images/loop.pdf

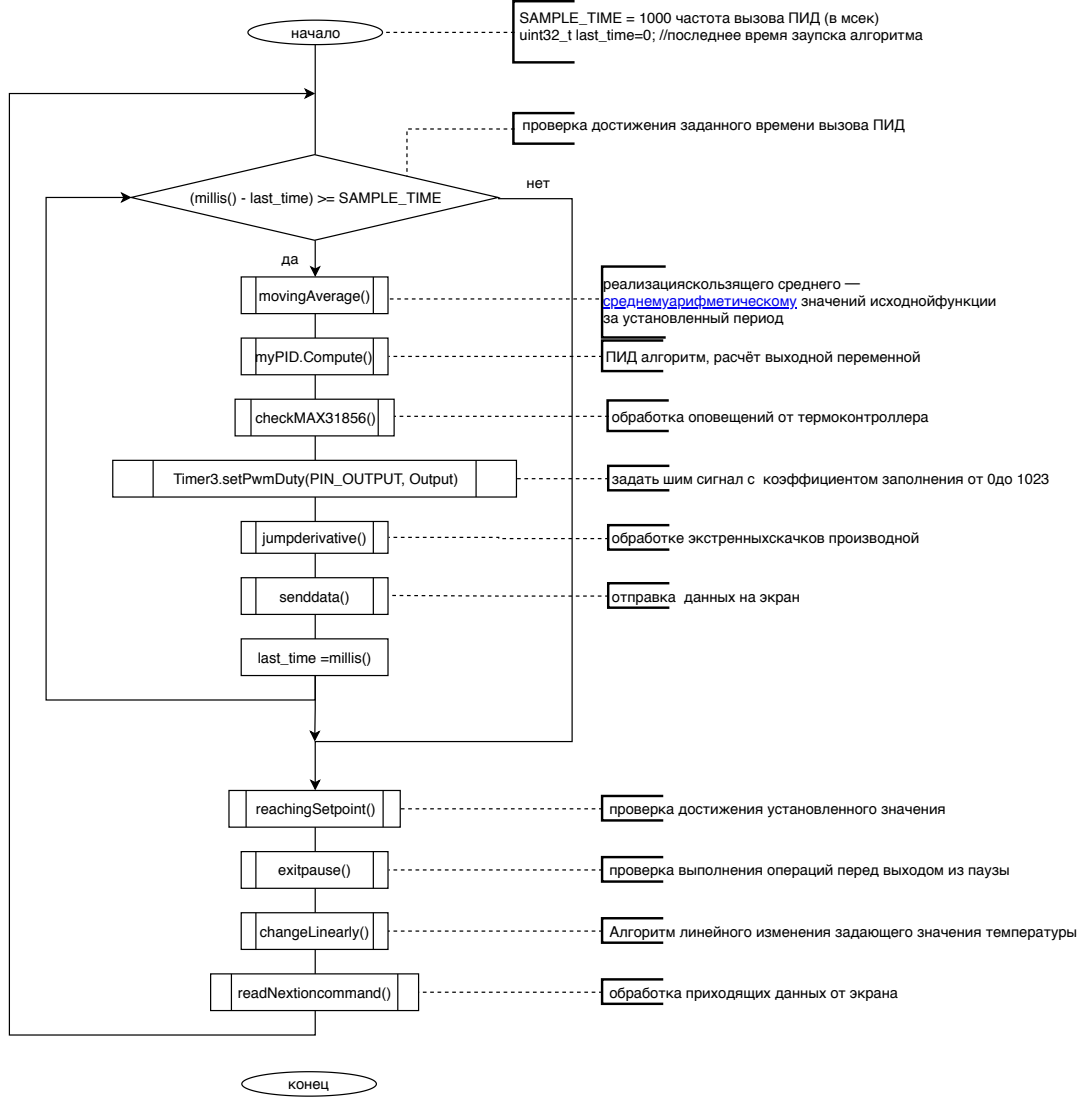
[picture p74: page 1]
начало; movingAverage(); myPID.Compute(); checkMAX31856(); jumpderivative(); Timer3.setPwmDuty(PIN_OUTPUT, Output); senddata(); last_time =millis(); reachingSetpoint(); exitpause(); changeLinearly(); readNextioncommand(); (millis() - last_time) >= SAMPLE_TIME; нет; конец

SAMPLE_TIME = 1000 частота вызова ПИД (в мсек)
uint32_t last_time=0; //последнее время заупска алгоритма

проверка достижения заданного времени вызова ПИД

реализацияскользящего среднего ─
среднемуарифметическому (https://ru.wikipedia.org/wiki/%D0%A1%D1%80%D0%B5%D0%B4%D0%BD%D0%B5%D0%B5_%D0%B0%D1%80%D0%B8%D1%84%D0%BC%D0%B5%D1%82%D0%B8%D1%87%D0%B5%D1%81%D0%BA%D0%BE%D0%B5) значений исходнойфункции
за установленный период

ПИД алгоритм, расчёт выходной переменной

обработка оповещений от термоконтроллера

задать шим сигнал с коэффициентом заполнения от 0до 1023

обработке экстренныхскачков производной

отправка данных на экран

проверка достижения установленного значения

проверка выполнения операций перед выходом из паузы

Алгоритм линейного изменения задающего значения температуры

обработка приходящих данных от экрана
